marcusfolkesson/mysensor-board/mysensor.brd

## EAGLE design mysensor.brd (2016-06-11)

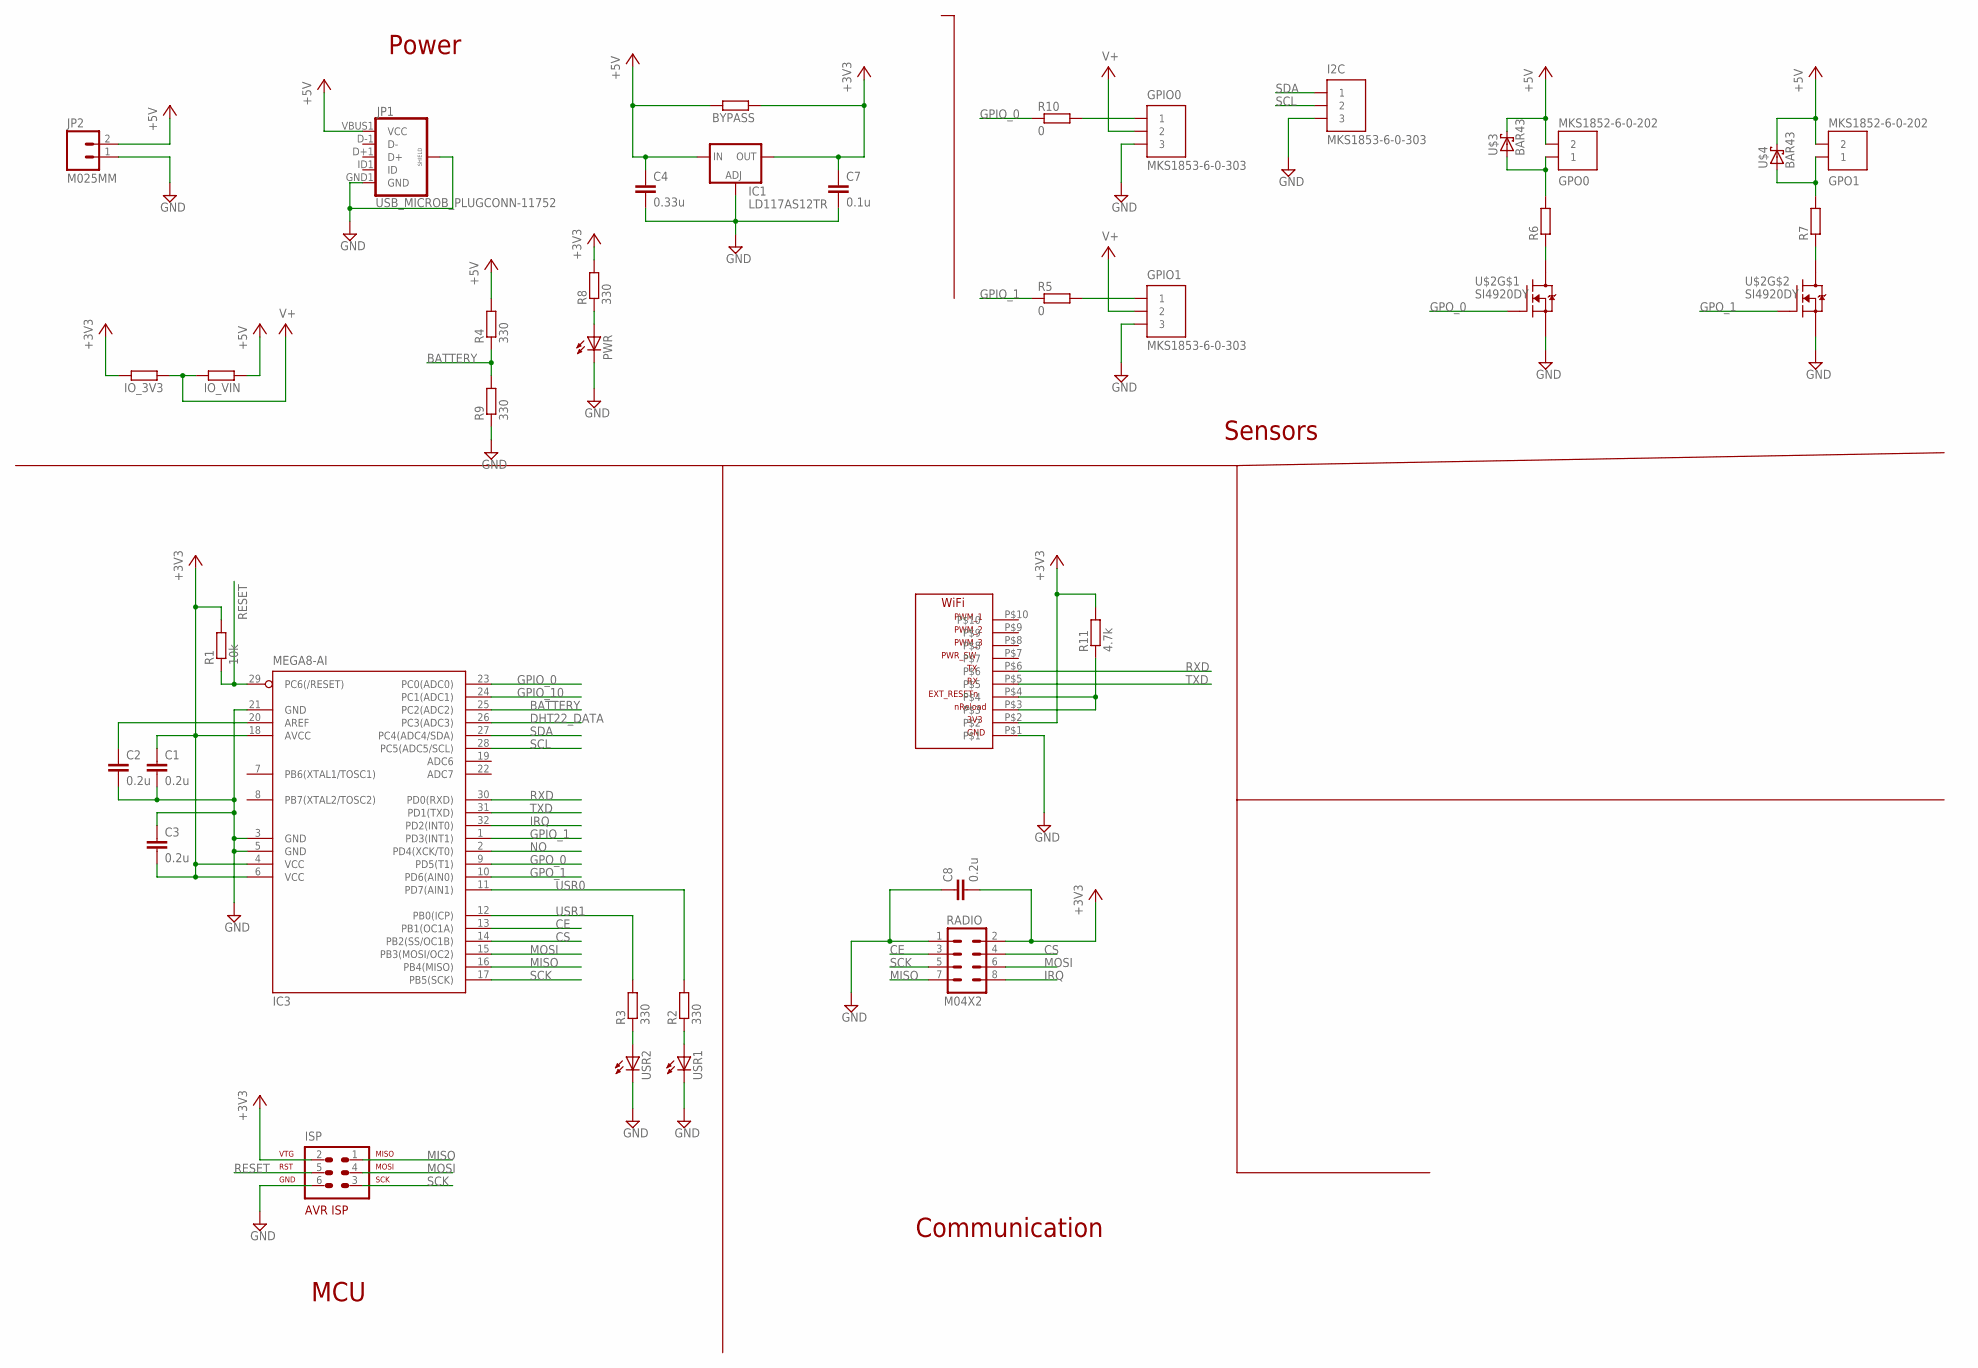
[picture p1: schematic mysensor.sch]

Parts:
BYPASS: R-EU_M0805; M0805
C1, C2, C3, C8: 0.2u; C0805
C4: 0.33u; C0805
C7: 0.1u; C0805
GPIO0, GPIO1: MKS1853-6-0-303
GPO0, GPO1: MKS1852-6-0-202
I2C: MKS1853-6-0-303
IC1: LD117AS12TR; SOT223
IC3: MEGA8-AI; TQFP32-08
IO_3V3: R-EU_M0805; M0805
IO_VIN: R-EU_M0805; M0805
ISP: AVR-ISP-6
JP1: USB_MICROB_PLUGCONN-11752; USB-B-MICRO-SMD_V03
JP2: M025MM; SCREWTERMINAL-5MM-2
PWR: LEDCHIP-LED0805; CHIP-LED0805
R1: 10k; R0805
R2, R3, R4, R8, R9: 330; M0805
R5, R10: 0; R0805
R6, R7: R-EU_M0805; M0805
R11: 4.7k; M0805
RADIO: M04X2; 2X4
U$1: WIFI232; WLAN
U$2: SI4920DY; SO-8
U$3, U$4: BAR43; SOT23
USR1, USR2: LEDCHIP-LED0805; CHIP-LED0805

Connections:
+3V3: BYPASS.1, C1.1, C3.2, C7.1, C8.2, IC1.4 (OUT), IC3.4 (VCC), IC3.6 (VCC), IC3.18 (AVCC), IO_3V3.2, ISP.2, R1.2, R8.2, R11.2, RADIO.2, U$1.P$2
+5V: BYPASS.2, C4.1, GPO0.2, GPO1.2, IC1.3 (IN), IO_VIN.1, JP1.VBUS1 (VCC), JP2.2, R4.2, U$3.3 (C), U$4.3 (C)
BATTERY: IC3.25 (PC2(ADC2)), R4.1, R9.2
CE: IC3.13 (PB1(OC1A)), RADIO.3
CS: IC3.14 (PB2(SS/OC1B)), RADIO.4
DHT22_DATA: IC3.26 (PC3(ADC3))
GND: C1.2, C2.2, C3.1, C4.2, C7.2, C8.1, GPIO0.3, GPIO1.3, I2C.3, IC1.1 (ADJ), IC3.3 (GND), IC3.5 (GND), IC3.21 (GND), ISP.6, JP1.GND1 (GND), JP1.SHIELD1 (SHIELD), JP1.SHIELD2 (SHIELD), JP1.SHIELD3 (SHIELD), JP2.1, PWR.C, R9.1, RADIO.1, U$1.P$1, U$2.1 (S), U$2.3 (S), USR1.C, USR2.C
GPIO_0: IC3.23 (PC0(ADC0)), R10.1
GPIO_1: IC3.1 (PD3(INT1)), R5.1
GPIO_10: IC3.24 (PC1(ADC1))
GPO_0: IC3.9 (PD5(T1)), U$2.2 (G)
GPO_1: IC3.10 (PD6(AIN0)), U$2.4 (G)
IRQ: IC3.32 (PD2(INT0)), RADIO.8
MISO: IC3.16 (PB4(MISO)), ISP.1, RADIO.7
MOSI: IC3.15 (PB3(MOSI/OC2)), ISP.4, RADIO.6
unnamed: R6.1, U$2.7 (D1)
unnamed: PWR.A, R8.1
unnamed: R2.1, USR1.A
unnamed: R3.1, USR2.A
unnamed: GPO0.1, R6.2, U$3.1 (A)
unnamed: GPIO1.1, R5.2
unnamed: R11.1, U$1.P$3, U$1.P$4
unnamed: GPIO0.1, R10.2
unnamed: R7.1, U$2.5 (D1)
unnamed: GPO1.1, R7.2, U$4.1 (A)
unnamed: C2.1, IC3.20 (AREF)
NO: IC3.2 (PD4(XCK/T0))
RESET: IC3.29 (PC6(/RESET)), ISP.5, R1.1
RXD: IC3.30 (PD0(RXD)), U$1.P$6
SCK: IC3.17 (PB5(SCK)), ISP.3, RADIO.5
SCL: I2C.2, IC3.28 (PC5(ADC5/SCL))
SDA: I2C.1, IC3.27 (PC4(ADC4/SDA))
TXD: IC3.31 (PD1(TXD)), U$1.P$5
USR0: IC3.11 (PD7(AIN1)), R2.2
USR1: IC3.12 (PB0(ICP)), R3.2
V+: GPIO0.2, GPIO1.2, IO_3V3.1, IO_VIN.2

Notes on the sheet:
Power
Sensors
MCU
Communication

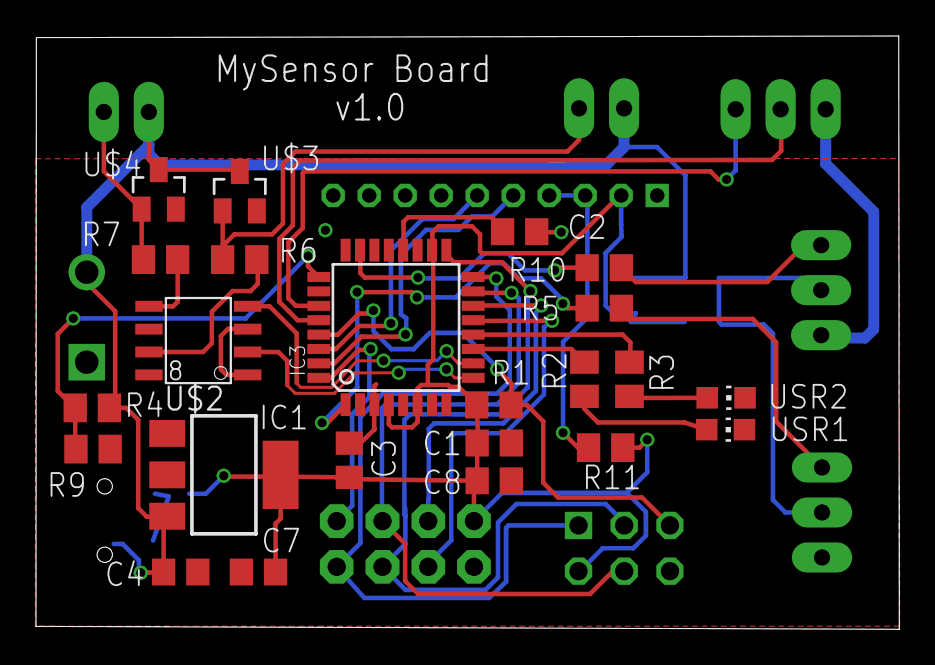
[picture p2: board mysensor.brd from above]

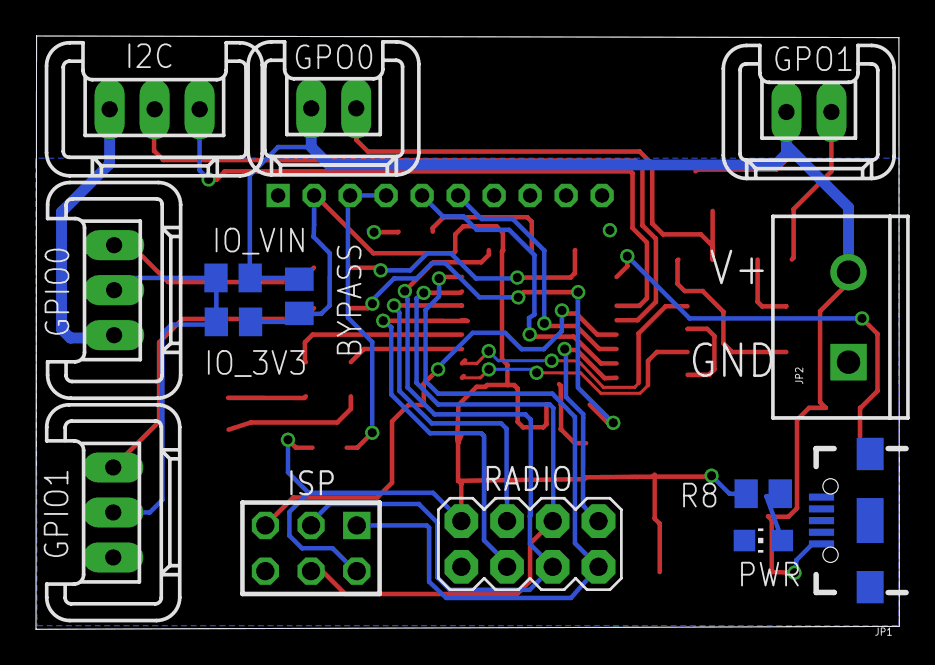
[picture p3: board mysensor.brd from below]

Board: 2 copper layers, 48.0 x 33.0 mm, 38 parts (14 on the bottom side), 33 nets.
