marcusfolkesson/mysensor-board/(commit log)

2016-02-14 Updates for rev 1.0
    * Moved LDO to left, too close to pin header
    * Moved USR1/2 to right for not covered by wifi module
    * Removed ground plane under pcb antenna
    * Moved GPIO_1 to INT1
    * Possible to read battery power by ADC
    * Add V+ and GND text to skruvplint
    [mysensor.brd, mysensor.sch]
2016-06-11 Unknown changes
    [mysensor.brd, mysensor.sch]
